TwentyTwoHW/portal-hardware/README.md

# portal-hardware

Kicad project containing the Portal board design.
