TwentyTwoHW/portal-hardware/3D_Models/NT3H21111.step

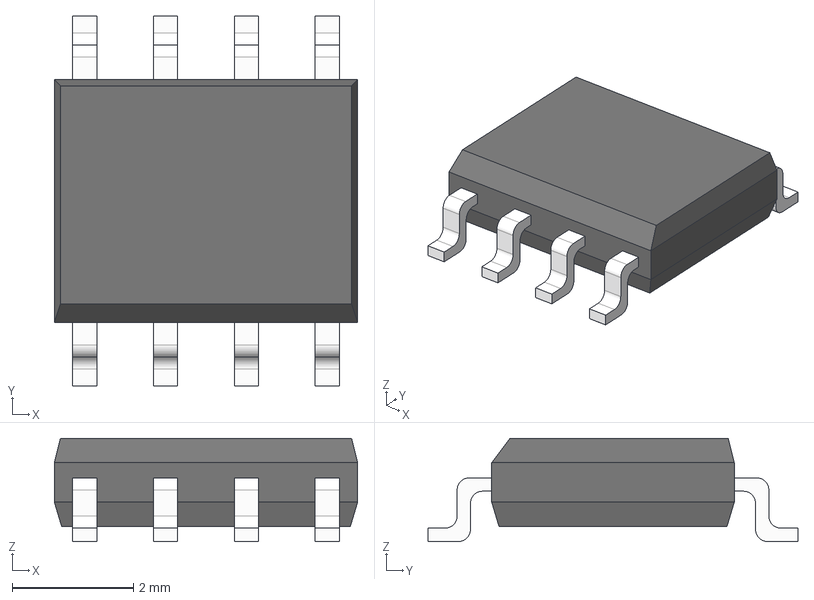
[picture p1: CAD file, 2024-03-01]
3D_Models/NT3H21111.step
5.00 x 6.10 x 1.70 mm
