TwentyTwoHW/portal-hardware/case/portal_upper_Rev-2.stp

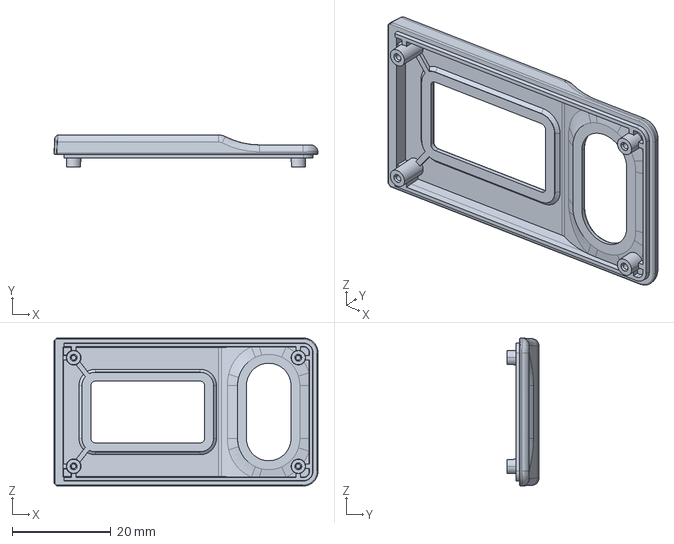
[picture p2: CAD file, 2024-07-16]
case/portal_upper_Rev-2.stp
53.5 x 6.50 x 30.0 mm
