TwentyTwoHW/portal-hardware/3D_Models/OLED.step

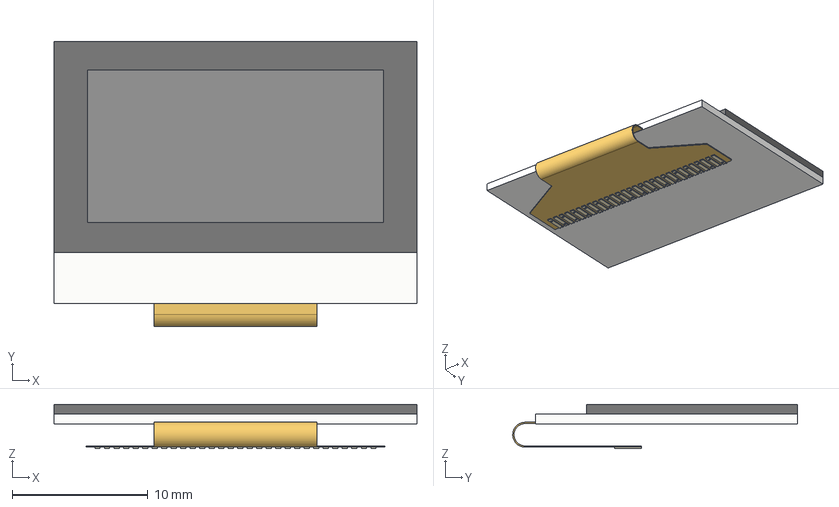
[picture p3: CAD file, 2024-03-01]
3D_Models/OLED.step
26.7 x 20.9 x 3.25 mm
