TwentyTwoHW/portal-hardware/case/portal_lower_Rev-4.stp

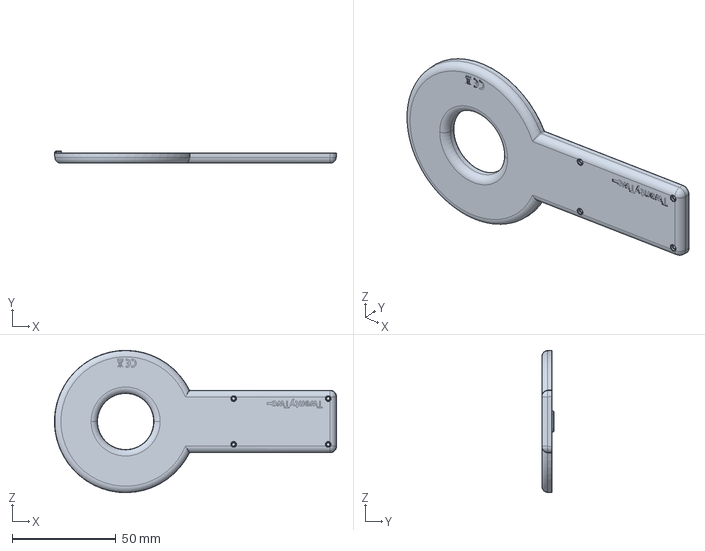
[picture p4: CAD file, 2024-07-16]
case/portal_lower_Rev-4.stp
135.7 x 6.00 x 68.5 mm
