TwentyTwoHW/portal-hardware/PCB.kicad_pcb

## KiCad design PCB.kicad_pcb (2024-07-16)

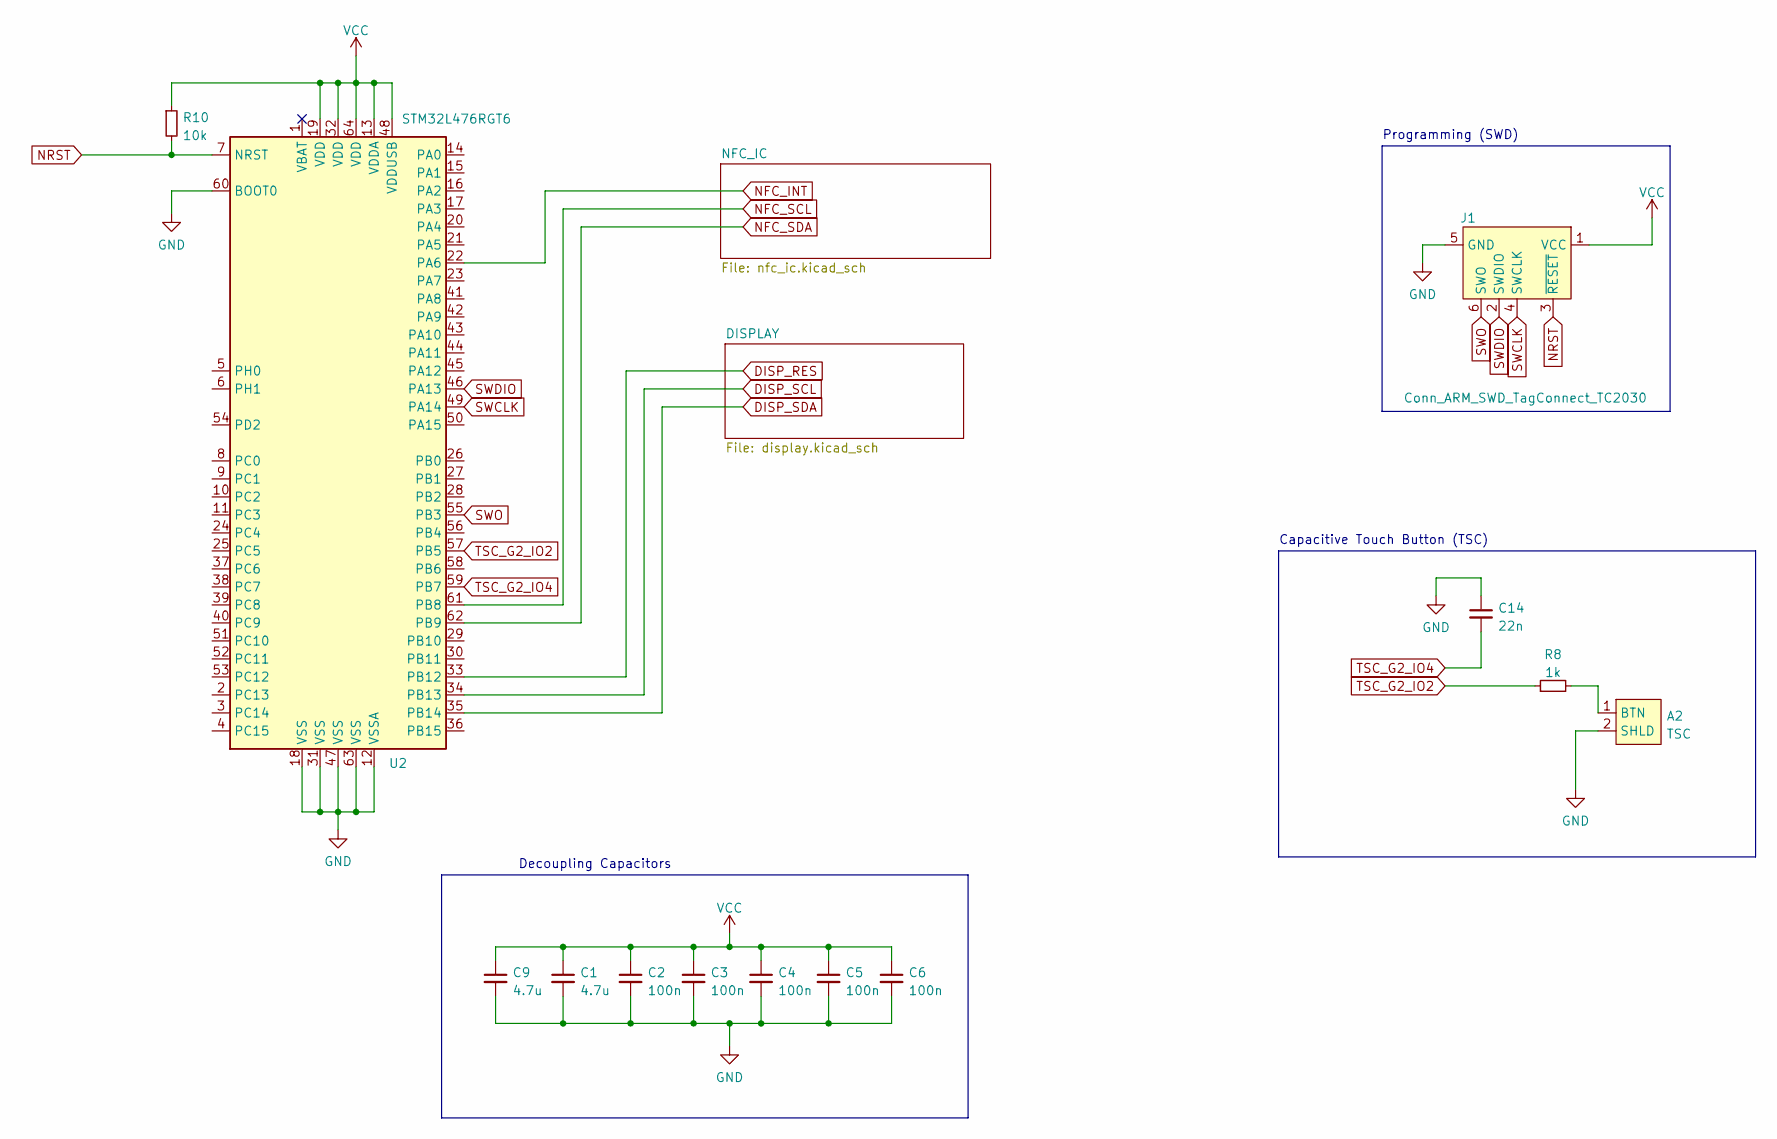
[picture p5: schematic PCB.kicad_sch]

Parts:
A2: TSC; TSC-Rectangle-25x16mm
C1, C9: 4.7u; C_0805_2012Metric
C2, C3, C4, C5, C6: 100n; C_0603_1608Metric
C14: 22n; C_0603_1608Metric
J1: Conn_ARM_SWD_TagConnect_TC2030; Tag-Connect_TC2030-IDC-NL_2x03_P1.27mm_Vertical
R8: 1k; R_0603_1608Metric
R10: 10k; R_0603_1608Metric
U2: STM32L476RGT6; LQFP-64_10x10mm_P0.5mm

Connections:
DISP_RES: U2.33 (PB12); also elsewhere on the board
DISP_SCL: U2.34 (PB13); also elsewhere on the board
DISP_SDA: U2.35 (PB14); also elsewhere on the board
GND: A2.2 (SHLD), C1.2, C2.2, C3.2, C4.2, C5.2, C6.2, C9.2, C14.1, J1.5 (GND), U2.12 (VSSA), U2.18 (VSS), U2.31 (VSS), U2.47 (VSS), U2.60 (BOOT0), U2.63 (VSS); also elsewhere on the board
NFC_INT: U2.22 (PA6); also elsewhere on the board
NFC_SCL: U2.61 (PB8); also elsewhere on the board
NFC_SDA: U2.62 (PB9); also elsewhere on the board
NRST: J1.3 (~RESET), R10.2, U2.7 (NRST)
unnamed: A2.1 (BTN), R8.2
SWCLK: J1.4 (SWCLK), U2.49 (PA14)
SWDIO: J1.2 (SWDIO), U2.46 (PA13)
SWO: J1.6 (SWO), U2.55 (PB3)
TSC_G2_IO2: R8.1, U2.57 (PB5)
TSC_G2_IO4: C14.2, U2.59 (PB7)
VCC: C1.1, C2.1, C3.1, C4.1, C5.1, C6.1, C9.1, J1.1 (VCC), R10.1, U2.13 (VDDA), U2.19 (VDD), U2.32 (VDD), U2.48 (VDDUSB), U2.64 (VDD); also elsewhere on the board

Notes on the sheet:
Programming (SWD)
Capacitive Touch Button (TSC)
Decoupling Capacitors

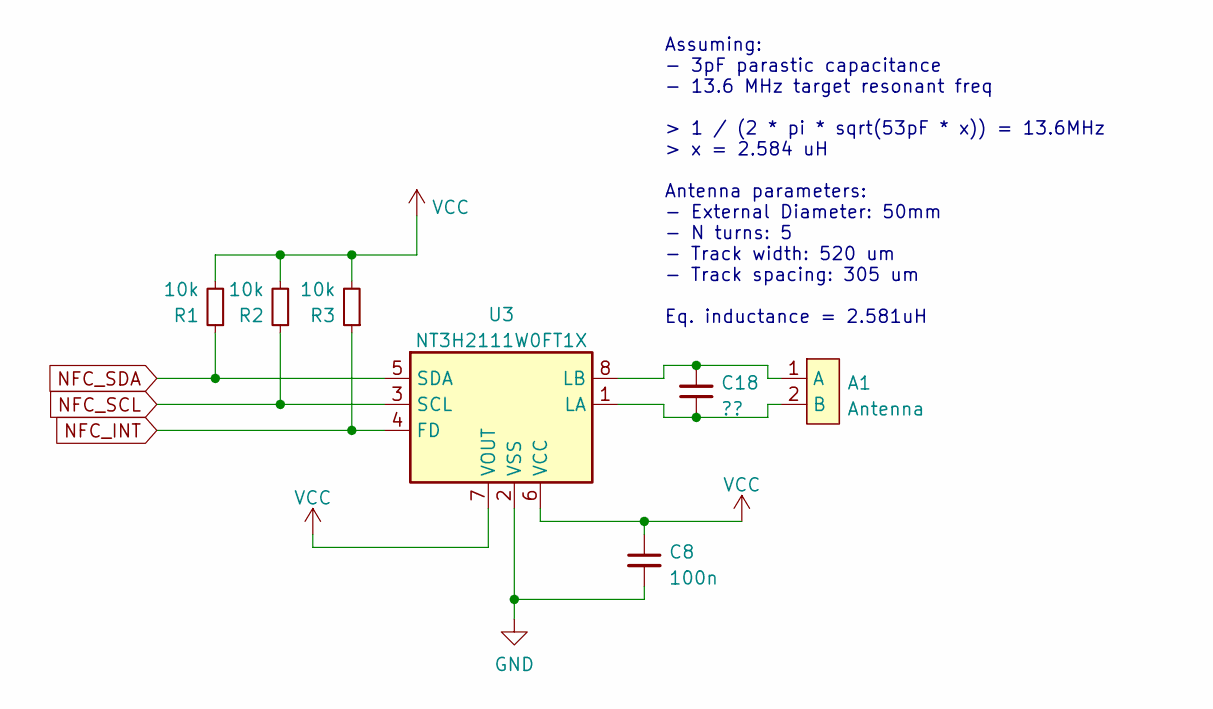
[picture p6: schematic nfc_ic.kicad_sch]

Parts:
A1: Antenna; Antenna-Round-13.8MHz-53pF-Class3-50mm
C8: 100n; C_0603_1608Metric
C18: ??; C_0603_1608Metric
R1, R2, R3: 10k; R_0603_1608Metric
U3: NT3H2111W0FT1X; SOT96-1

Connections:
GND: C8.2, U3.2 (VSS); also elsewhere on the board
NFC_INT: R3.1, U3.4 (FD); also elsewhere on the board
NFC_SCL: R2.1, U3.3 (SCL); also elsewhere on the board
NFC_SDA: R1.1, U3.5 (SDA); also elsewhere on the board
unnamed: A1.1 (A), C18.2, U3.8 (LB)
unnamed: A1.2 (B), C18.1, U3.1 (LA)
VCC: C8.1, R1.2, R2.2, R3.2, U3.6 (VCC), U3.7 (VOUT); also elsewhere on the board

Notes on the sheet:
Assuming: - 3pF parastic capacitance - 13.6 MHz target resonant freq > 1 / (2 * pi * sqrt(53pF * x)) = 13.6MHz > x = 2.584 uH Antenna parameters: - External Diameter: 50mm - N turns: 5 - Track width: 520 um - Track spacing: 305 um Eq. inductance = 2.581uH

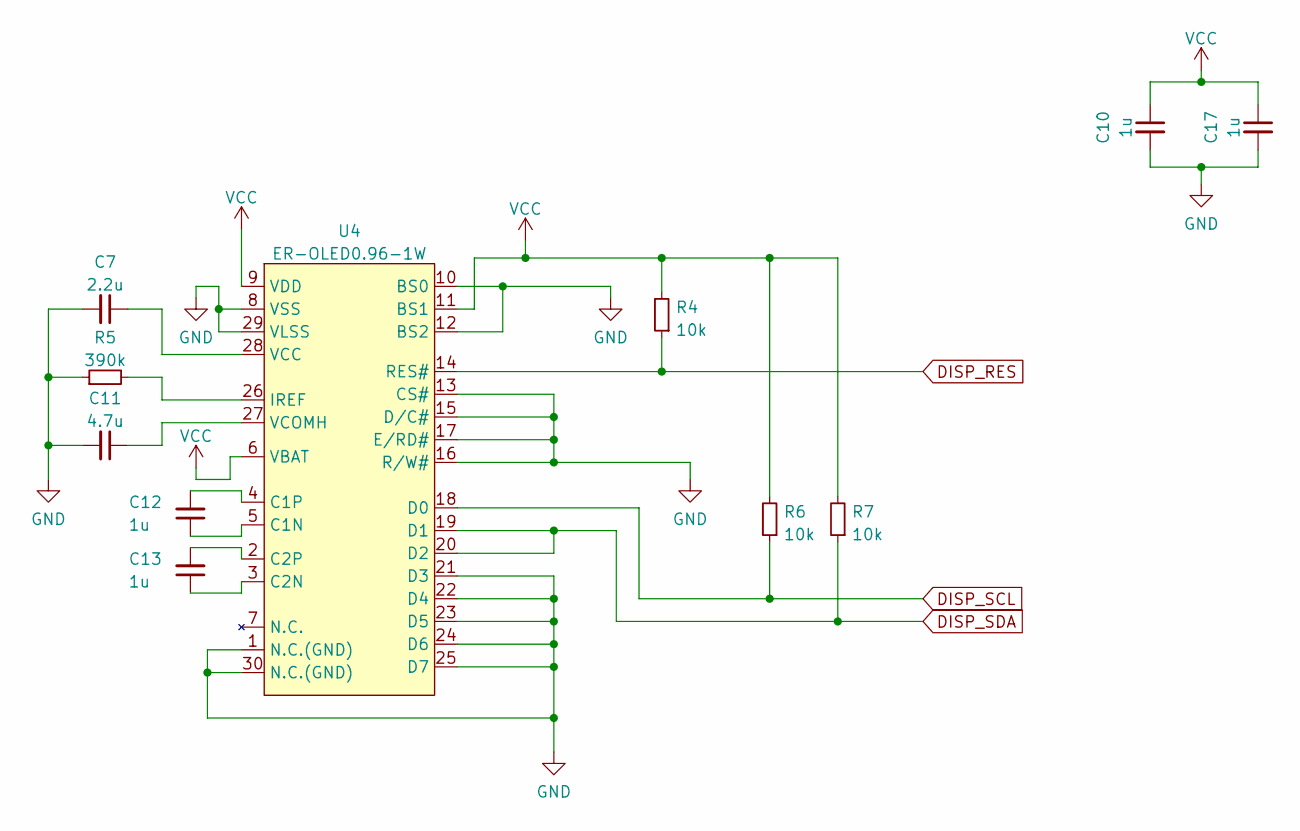
[picture p7: schematic display.kicad_sch]

Parts:
C7: 2.2u; C_0603_1608Metric
C10, C12, C13, C17: 1u; C_0603_1608Metric
C11: 4.7u; C_0805_2012Metric
R4, R6, R7: 10k; R_0603_1608Metric
R5: 390k; R_0603_1608Metric
U4: ER-OLED0.96-1W; OLED-128O064D-WITH-FP

Connections:
DISP_RES: R4.1, U4.14 (RES#); also elsewhere on the board
DISP_SCL: R6.1, U4.18 (D0); also elsewhere on the board
DISP_SDA: R7.1, U4.19 (D1), U4.20 (D2); also elsewhere on the board
GND: C7.2, C10.2, C11.2, C17.2, R5.1, U4.1 (N.C.(GND)), U4.8 (VSS), U4.10 (BS0), U4.12 (BS2), U4.13 (CS#), U4.15 (D/C#), U4.16 (R/W#), U4.17 (E/RD#), U4.21 (D3), U4.22 (D4), U4.23 (D5), U4.24 (D6), U4.25 (D7), U4.29 (VLSS), U4.30 (N.C.(GND)); also elsewhere on the board
unnamed: C12.1, U4.5 (C1N)
unnamed: C12.2, U4.4 (C1P)
unnamed: C13.1, U4.3 (C2N)
unnamed: C13.2, U4.2 (C2P)
unnamed: R5.2, U4.26 (IREF)
unnamed: C7.1, U4.28 (VCC)
unnamed: C11.1, U4.27 (VCOMH)
VCC: C10.1, C17.1, R4.2, R6.2, R7.2, U4.6 (VBAT), U4.9 (VDD), U4.11 (BS1); also elsewhere on the board

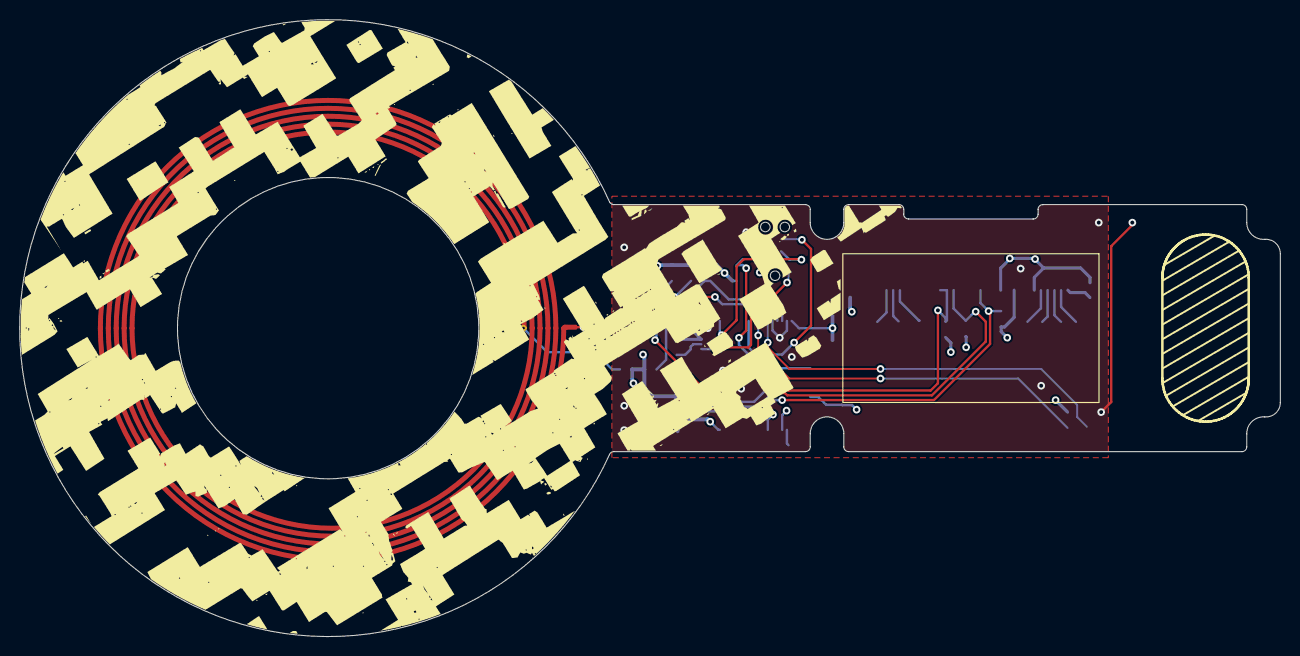
[picture p8: board PCB.kicad_pcb from above]

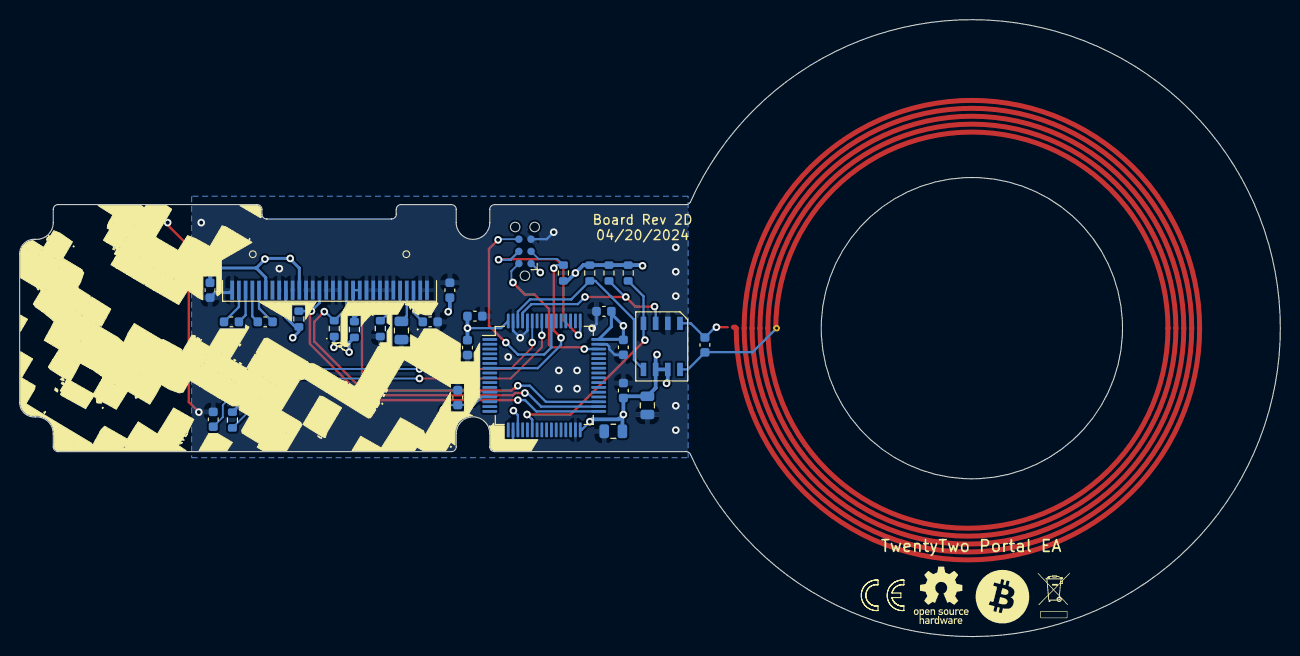
[picture p9: board PCB.kicad_pcb from below]

Board: 4 copper layers, 131.4 x 64.3 mm, 31 parts (30 on the bottom side), 24 nets.
