TwentyTwoHW/portal-hardware/(commit log)

2024-07-16 Add board REV-D
    Revision D changes the mounting holes so that we can fit screws to
    assemble the two case pieces.
    Also add required compliance logos on the back.
    [PCB.kicad_pcb, PCB.kicad_sch, display.kicad_sch, nfc_ic.kicad_sch]
2024-07-16 Add STEP files of the case
    [portal_lower_Rev-4.stp, portal_upper_Rev-2.stp]
